Kybernetika-SPSE/Augusta_Digitronov-hodiny/plakat.png

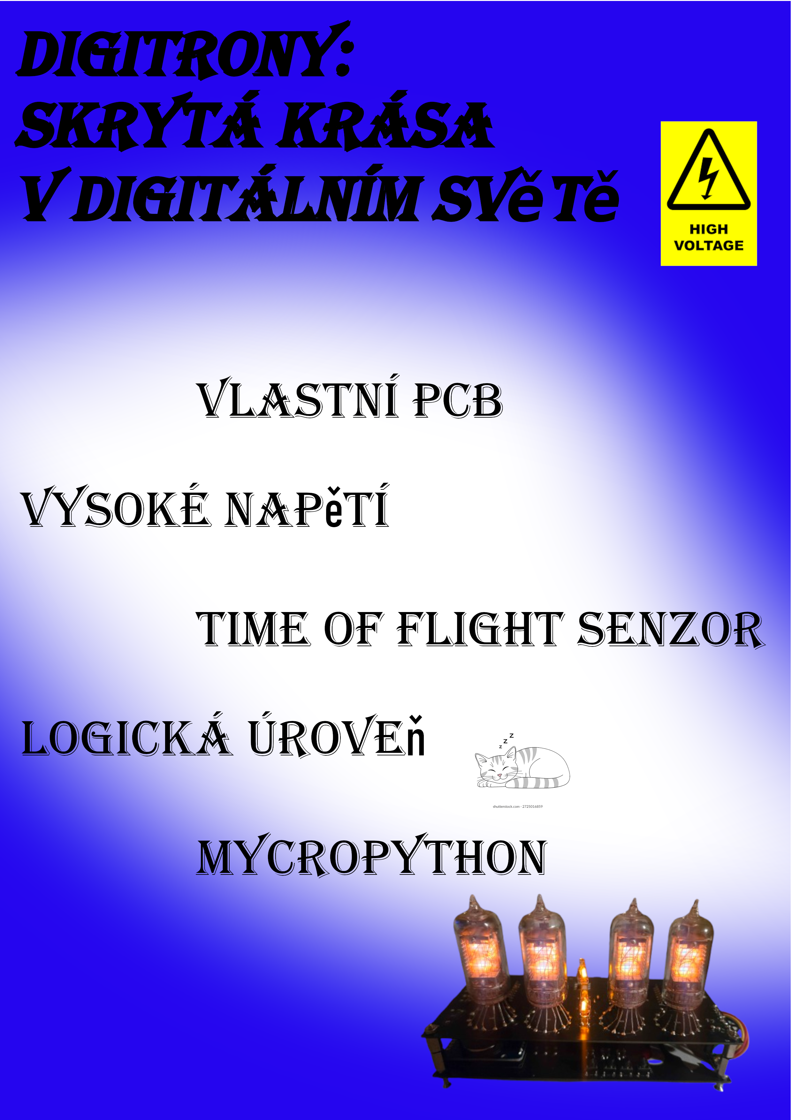
plakat.png
