Kybernetika-SPSE/Augusta_Digitronov-hodiny/Digitronevé hod/HV part/Digitronove hodiny LV.kicad_pcb

## KiCad design Digitronevé hod/HV part/Digitronove hodiny LV.kicad_pcb (2026-04-09)

Schematic: Digitronove hodiny LV.kicad_sch

Parts:
C1, C9: 100 uF; CP_Radial_D6.3mm_P2.50mm
C2, C3, C4, C5, C6, C7: 100 nF; C_1206_3216Metric_Pad1.33x1.80mm_HandSolder
C8: 4.7 µF; CP_Radial_D10.0mm_P5.00mm
H1, H2, H3: MountingHole; MountingHole_2.5mm
J1: Conn_01x02; JST_EH_B2B-EH-A_1x02_P2.50mm_Vertical
J2: Conn_01x09; JST_EH_B9B-EH-A_1x09_P2.50mm_Vertical
NE1, NE2: Lamp_Neon; C_Rect_L4.0mm_W2.5mm_P2.50mm
Q1: MPSA42; TO-92_Inline
R1: 100K; R_Axial_DIN0207_L6.3mm_D2.5mm_P10.16mm_Horizontal
R2, R3, R4, R5: 10k; R_Axial_DIN0207_L6.3mm_D2.5mm_P10.16mm_Horizontal
R6, R7: 180k; R_Axial_DIN0207_L6.3mm_D2.5mm_P10.16mm_Horizontal
R8: 1M; R_Axial_DIN0207_L6.3mm_D2.5mm_P10.16mm_Horizontal
R9: 1k; R_Axial_DIN0207_L6.3mm_D2.5mm_P10.16mm_Horizontal
U1, U2: 74HC595; 74HC595N
U3, U4, U5, U6: K155id1; 74141
U7, U8, U9, U10: Tesla_ZM1082

Connections:
/0a: U6.16 (Q0), U10.11 (k9)
/0b: U5.16 (Q0), U9.11 (k9)
/0c: U4.16 (Q0), U8.11 (k9)
/0d: U3.16 (Q0), U7.11 (k9)
/1a: U6.15 (Q1), U10.9 (k8)
/1b: U5.15 (Q1), U9.9 (k8)
/1c: U4.15 (Q1), U8.9 (k8)
/1d: U3.15 (Q1), U7.9 (k8)
/2a: U6.8 (Q2), U10.8 (k7)
/2b: U5.8 (Q2), U9.8 (k7)
/2c: U4.8 (Q2), U8.8 (k7)
/2d: U3.8 (Q2), U7.8 (k7)
/3a: U6.9 (Q3), U10.7 (k6)
/3b: U5.9 (Q3), U9.7 (k6)
/3c: U4.9 (Q3), U8.7 (k6)
/3d: U3.9 (Q3), U7.7 (k6)
/4a: U6.13 (Q4), U10.6 (k5)
/4b: U5.13 (Q4), U9.6 (k5)
/4c: U4.13 (Q4), U8.6 (k5)
/4d: U3.13 (Q4), U7.6 (k5)
/5a: U6.14 (Q5), U10.5 (k4)
/5b: U5.14 (Q5), U9.5 (k4)
/5c: U4.14 (Q5), U8.5 (k4)
/5d: U3.14 (Q5), U7.5 (k4)
/6a: U6.11 (Q6), U10.3 (k3)
/6b: U5.11 (Q6), U9.3 (k3)
/6c: U4.11 (Q6), U8.3 (k3)
/6d: U3.11 (Q6), U7.3 (k3)
/7a: U6.10 (Q7), U10.2 (k2)
/7b: U5.10 (Q7), U9.2 (k2)
/7c: U4.10 (Q7), U8.2 (k2)
/7d: U3.10 (Q7), U7.2 (k2)
/8a: U6.1 (Q8), U10.1 (k1)
/8b: U5.1 (Q8), U9.1 (k1)
/8c: U4.1 (Q8), U8.1 (k1)
/8d: U3.1 (Q8), U7.1 (k1)
/9a: U6.2 (Q9), U10.12 (k0)
/9b: U5.2 (Q9), U9.12 (k0)
/9c: U4.2 (Q9), U8.12 (k0)
/9d: U3.2 (Q9), U7.12 (k0)
/+3V3: C1.1, C1.2, C2.2, C3.2, J2.3, U1.10 (~SRCLR), U1.16 (VCC), U2.10 (~SRCLR), U2.16 (VCC)
/+170V: C8.1, J1.2, NE1.1, NE1.2, NE2.1, NE2.2, Q1.1 (E), R2.1, R2.2, R3.1, R3.2, R4.1, R4.2, R5.1, R5.2, R6.1, R6.2, R7.1, R7.2, R8.2, R9.1, R9.2, U7.13 (a), U8.13 (a), U9.13 (a), U10.13 (a)
/A1: U2.15 (QA), U6.3 (A)
/A2: U2.4 (QE), U5.3 (A)
/A3: U1.15 (QA), U4.3 (A)
/A4: U1.4 (QE), U3.3 (A)
/B1: U2.1 (QB), U6.6 (B)
/B2: U2.5 (QF), U5.6 (B)
/B3: U1.1 (QB), U4.6 (B)
/B4: U1.5 (QF), U3.6 (B)
/C1: U2.2 (QC), U6.7 (C)
/C2: U2.6 (QG), U5.7 (C)
/C3: U1.2 (QC), U4.7 (C)
/C4: U1.6 (QG), U3.7 (C)
/D1: U2.3 (QD), U6.4 (D)
/D2: U2.7 (QH), U5.4 (D)
/D3: U1.3 (QD), U4.4 (D)
/D4: U1.7 (QH), U3.4 (D)
/NE1,2: J2.1, Q1.2 (B), R1.1
/OE: J2.8, U1.13 (~OE), U2.13 (~OE)
/RLCK: J2.7, U1.12 (RCLK), U2.12 (RCLK)
/SER1: J2.9, U2.14 (SER)
/SER2: U1.14 (SER), U2.9 (QH')
/SRLCK: J2.6, U1.11 (SRCLK), U2.11 (SRCLK)
GND: C2.1, C3.1, C4.2, C5.2, C6.2, C7.2, C8.2, J1.1, J2.4, J2.5, Q1.3 (C), R1.2, R8.1, U1.8 (GND), U2.8 (GND), U3.12 (GND), U4.12 (GND), U5.12 (GND), U6.12 (GND)

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
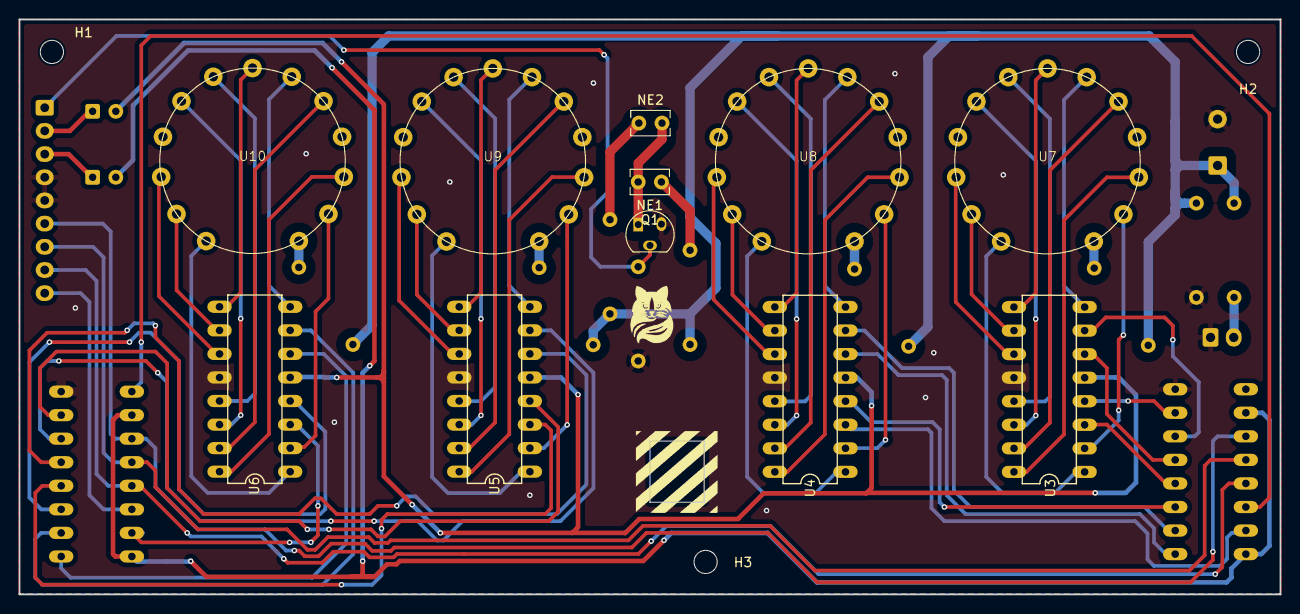
[picture p2: board Digitronevé hod/HV part/Digitronove hodiny LV.kicad_pcb from above]

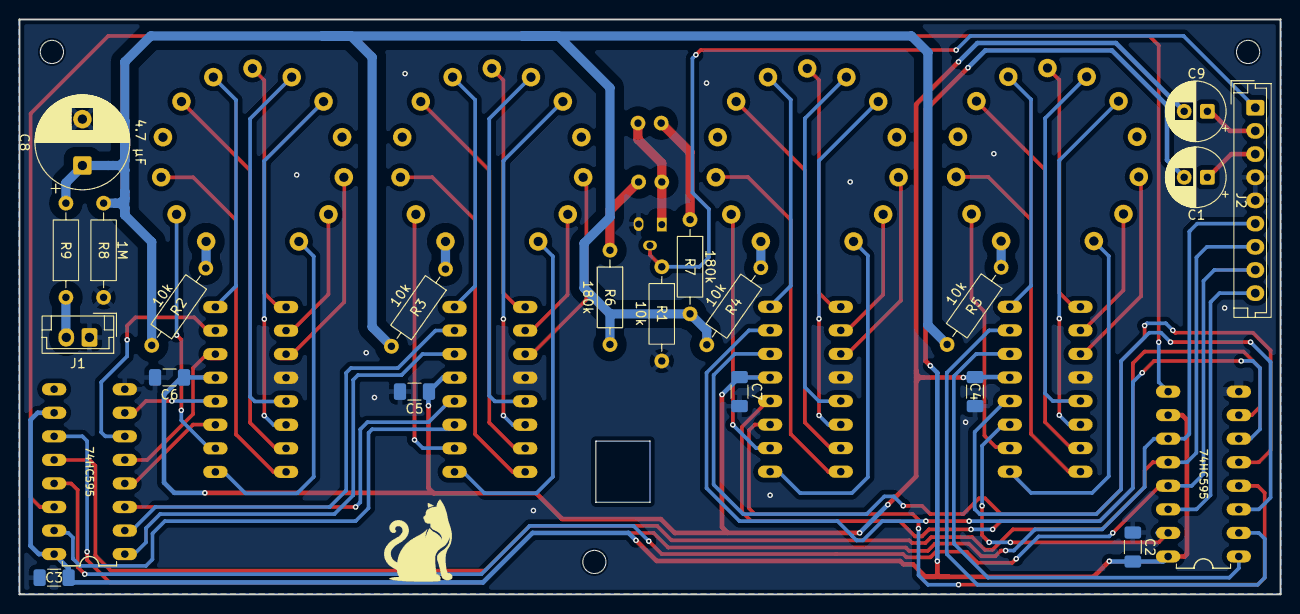
[picture p3: board Digitronevé hod/HV part/Digitronove hodiny LV.kicad_pcb from below]

Board: 2 copper layers, 136.0 x 62.0 mm, 36 parts (22 on the bottom side), 66 nets.
