Kybernetika-SPSE/Augusta_Digitronov-hodiny/Digitronevé hod/LV part/Digitronove hodiny LV.kicad_pcb

## KiCad design Digitronevé hod/LV part/Digitronove hodiny LV.kicad_pcb (2026-04-09)

Schematic: Digitronove hodiny LV.kicad_sch, Dolní deska

Parts:
C1: 100uF; CP_Radial_D6.3mm_P2.50mm
C2, C3, C4: 100nF; C_1206_3216Metric_Pad1.33x1.80mm_HandSolder
D1: 1N5817; D_DO-41_SOD81_P10.16mm_Horizontal
DS1: Conn_01x06; DS3231
F1, F2: Fuse; Fuse_1812_4532Metric
H1, H2, H3: MountingHole; MountingHole_2.5mm
J1: PDC004-PD
J2: MAX1771
J4: GY-VL53L0X
Konektor1: Conn_01x09; JST_EH_B9B-EH-A_1x09_P2.50mm_Vertical
Q1: NPN
R1, R3: 10k; R_1206_3216Metric_Pad1.30x1.75mm_HandSolder
R2, R4, R5, R6, R7, R8, R9, R10, R11: 4.7k; R_1206_3216Metric_Pad1.30x1.75mm_HandSolder
SW1: START/STOP; SW_PUSH_6mm_H4.3mm
SW2: EN; SW_PUSH_6mm_H4.3mm
SW3: +1; SW_PUSH_6mm_H4.3mm
SW4: SWITCH; SW_PUSH_6mm_H4.3mm
U1: DD4012SA; Untitled_3
U2: ESP32 DevKit; MODULE_ESP32_DEVKIT_V1; PARTREV N/A

Connections:
/+1: C3.2, R10.2, U2.21 (D32)
/+3V3: DS1.+3V3, J4.+3V3, Konektor1.3, R1.1, R2.1, R4.2, R6.1, R6.2, R7.1, R8.1, R8.2, R9.1, R9.2, R10.1, R11.1, SW1.2, SW3.2, SW4.2, U2.1 (3V3)
/+5V: C1.1, D1.1 (K), D1.2 (A), Konektor1.2, U1.3 (OUT), U2.30 (VIN)
/+9V: F1.1, F1.2, F2.1, F2.2, J1.1, J2.VIN (Pin_1), U1.1 (IN)
/EN: SW2.2, U2.16 (EN)
/NE1,2: Konektor1.1, R5.1, R5.2, U2.4 (D2)
/OE: Konektor1.8, U2.14 (D22)
/RLCK: Konektor1.7, U2.23 (D25)
/SCL: DS1.SCL, J4.SCL, R2.2, U2.5 (D4)
/SDA: DS1.SDA, J4.SDA, R4.1, U2.9 (D18)
/SER1: Konektor1.9, U2.25 (D27)
/SHDN: J2.SHDN (Pin_3), Q1.1 (C), Q1.2 (B), R3.1, R3.2, U2.28 (D13)
/SQW: DS1.SQW, R1.2, U2.20 (D35)
/SRLCK: Konektor1.6, U2.24 (D26)
/START-STOP: C2.2, R7.2, U2.15 (D23)
/SWITCH: C4.2, R11.2, U2.22 (D33)
GND: C1.2, C2.1, C3.1, C4.1, DS1.GND, J1.2, J2.GND (Pin_2), J4.GND, Konektor1.4, Konektor1.5, Q1.3 (E), SW1.1, SW2.1, SW3.1, SW4.1, U1.2 (GND), U2.2 (GND), U2.29 (GND)

Notes on the sheet:
USB-C s modulem Ip2721

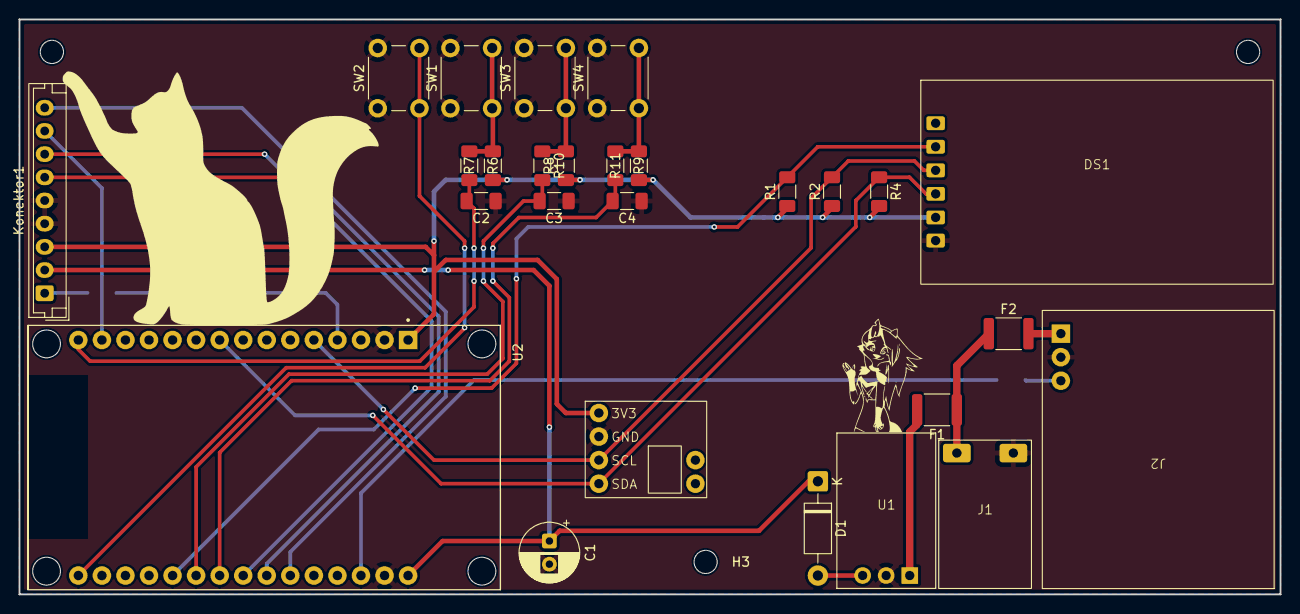
[picture p4: board Digitronevé hod/LV part/Digitronove hodiny LV.kicad_pcb from above]

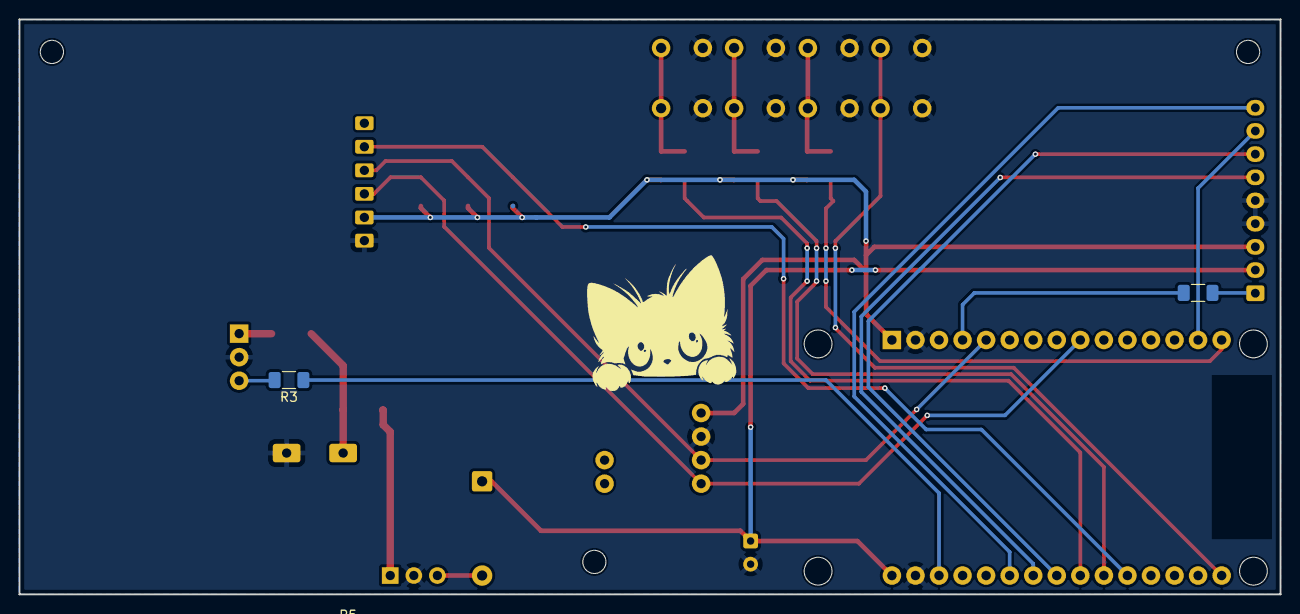
[picture p5: board Digitronevé hod/LV part/Digitronove hodiny LV.kicad_pcb from below]

Board: 2 copper layers, 136.0 x 62.0 mm, 32 parts (2 on the bottom side), 17 nets.
