Kybernetika-SPSE/Augusta_Digitronov-hodiny/(commit log)

2025-12-21 PCB 21.12.2025
    [Digitronove hodiny LV.kicad_pcb, Digitronove hodiny LV.kicad_sch]
2025-12-22 Dodání pouzder
    [Digitronove hodiny LV.kicad_pcb]
2025-12-22 Dodávní pouzder part2
    [Digitronove hodiny LV.kicad_sch]
2025-12-22 LV Schema
    [Digitronove hodiny LV.kicad_sch]
2025-12-26 schéma LV desky update
    [Digitronove hodiny LV.kicad_pcb, Digitronove hodiny LV.kicad_sch]
2025-12-26 PCB LV upravování pouzder
    [Digitronove hodiny LV.kicad_pcb, Digitronove hodiny LV.kicad_sch]
2025-12-28 Update Schéma LV
    [Digitronove hodiny LV.kicad_pcb, Digitronove hodiny LV.kicad_sch]
2025-12-28 Dokončení LV
    [Digitronove hodiny LV.kicad_pcb, Digitronove hodiny LV.kicad_sch]
2025-12-30 HV part schematic 01
    [Digitronove hodiny LV.kicad_sch]
2026-01-03 HV scheme update
    [Digitronove hodiny LV.kicad_sch]
2026-01-06 LV update
    [Digitronove hodiny LV.kicad_pcb, Digitronove hodiny LV.kicad_sch]
2026-02-05 Redesign LV
    [Digitronove hodiny LV.kicad_pcb, Digitronove hodiny LV.kicad_sch]
2026-02-16 Před kontrolou
    [Digitronove hodiny LV.kicad_pcb, Digitronove hodiny LV.kicad_sch]
2026-02-21 PCB finnal
    [Digitronove hodiny LV.kicad_pcb, Digitronove hodiny LV.kicad_sch]
2026-03-05 pcb uprava
    [Digitronove hodiny LV.kicad_pcb, Digitronove hodiny LV.kicad_sch]
2026-04-09 Final I hope
    [Digitronove hodiny LV-B_Cu.gbr, Digitronove hodiny LV-B_Mask.gbr, Digitronove hodiny LV-B_Paste.gbr, Digitronove hodiny LV-B_Silkscreen.gbr, Digitronove hodiny LV-Edge_Cuts.gbr, Digitronove hodiny LV-F_Cu.gbr, Digitronove hodiny LV-F_Mask.gbr, Digitronove hodiny LV-F_Paste.gbr]
2026-04-09 release meee
    [Digitronove hodiny LV.kicad_sch]
